Underwater-Robotic-System/Build-Instructions/images/camerastep1.jpg

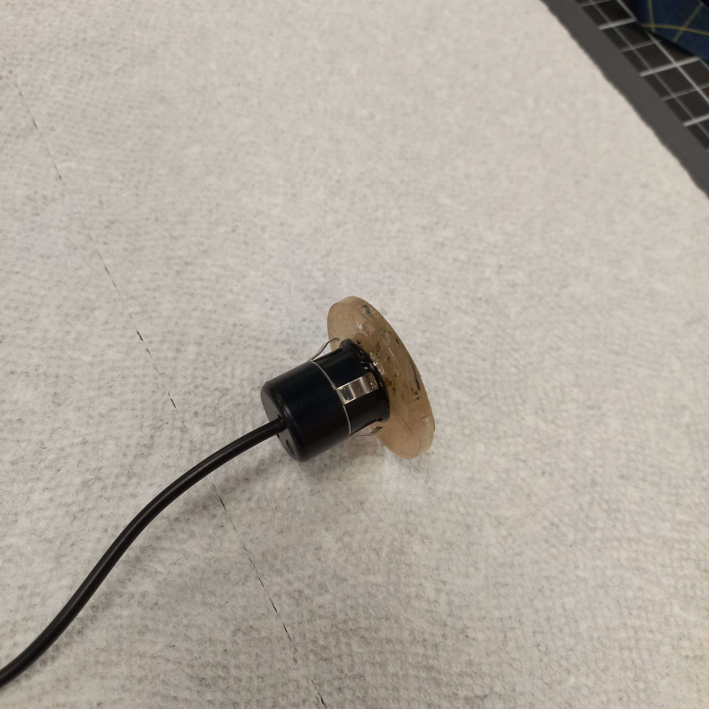
images/camerastep1.jpg
