Underwater-Robotic-System/Build-Instructions/repair_guide_code/depth_sensor_bar30_basic.ino

/* Blue Robotics MS5837 Library Example
-----------------------------------------------------

Title: Blue Robotics MS5837 Library Example

Description: This example demonstrates the MS5837 Library with a connected
sensor. The example reads the sensor and prints the resulting values
to the serial terminal.

The code is designed for the Arduino Uno board and can be compiled and
uploaded via the Arduino 1.0+ software.

-------------------------------
The MIT License (MIT)

Copyright (c) 2015 Blue Robotics Inc.

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
THE SOFTWARE IS PROVIDED "AS IS", WITHOUT WARRANTY OF ANY KIND, EXPRESS OR
IMPLIED, INCLUDING BUT NOT LIMITED TO THE WARRANTIES OF MERCHANTABILITY,
FITNESS FOR A PARTICULAR PURPOSE AND NONINFRINGEMENT. IN NO EVENT SHALL THE
AUTHORS OR COPYRIGHT HOLDERS BE LIABLE FOR ANY CLAIM, DAMAGES OR OTHER
LIABILITY, WHETHER IN AN ACTION OF CONTRACT, TORT OR OTHERWISE, ARISING FROM,
OUT OF OR IN CONNECTION WITH THE SOFTWARE OR THE USE OR OTHER DEALINGS IN
THE SOFTWARE.
-------------------------------*/

#include <Wire.h>
#include "MS5837.h"

MS5837 sensor;

void setup() {

  Serial.begin(9600);

  Serial.println("Starting");

  Wire.begin();

  // Initialize pressure sensor
  // Returns true if initialization was successful
  // We can't continue with the rest of the program unless we can initialize the sensor
  while (!sensor.init()) {
    Serial.println("Init failed!");
    Serial.println("Are SDA/SCL connected correctly?");
    Serial.println("Blue Robotics Bar30: White=SDA, Green=SCL");
    Serial.println("\n\n\n");
    delay(5000);
  }

  // .init sets the sensor model for us but we can override it if required.
  // Uncomment the next line to force the sensor model to the MS5837_30BA.
  //sensor.setModel(MS5837::MS5837_30BA);

  sensor.setFluidDensity(997); // kg/m^3 (freshwater, 1029 for seawater)
}

void loop() {
  // Update pressure and temperature readings
  sensor.read();

  Serial.print("Pressure: ");
  Serial.print(sensor.pressure());
  Serial.println(" mbar");

  Serial.print("Temperature: ");
  Serial.print(sensor.temperature());
  Serial.println(" deg C");

  Serial.print("Depth: ");
  Serial.print(sensor.depth());
  Serial.println(" m");

  Serial.print("Altitude: ");
  Serial.print(sensor.altitude());
  Serial.println(" m above mean sea level");

  delay(1000);
}
