Underwater-Robotic-System/Build-Instructions/(commit log)

2023-08-24 add data analysis
    [#1-pool-data.csv, #1_Pool_Water.csv, #2-drinkingwater.csv, #3-contaminatedwaterwithsoap.csv, final_data.csv, main-data.csv, sensor-data.csv]
2025-06-03 motor section of repair guide
