Underwater-Robotic-System/Build-Instructions/images/powercord.jpg

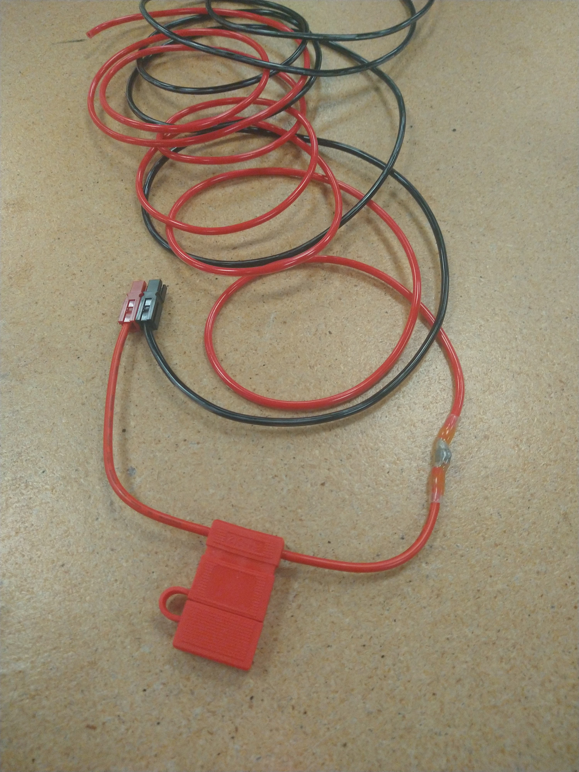
[picture p9: images/powercord.jpg]
images/powercord.jpg
