Underwater-Robotic-System/Build-Instructions/images/waterproofcam1.jpg

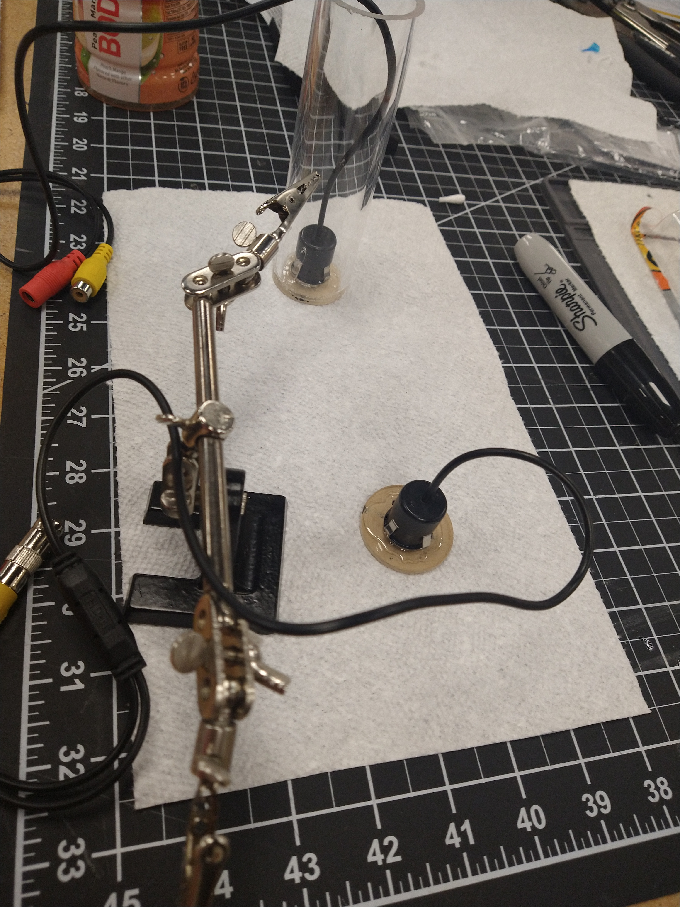
[picture p17: images/waterproofcam1.jpg]
images/waterproofcam1.jpg
