Underwater-Robotic-System/Build-Instructions/images/waterproofcam2.jpg

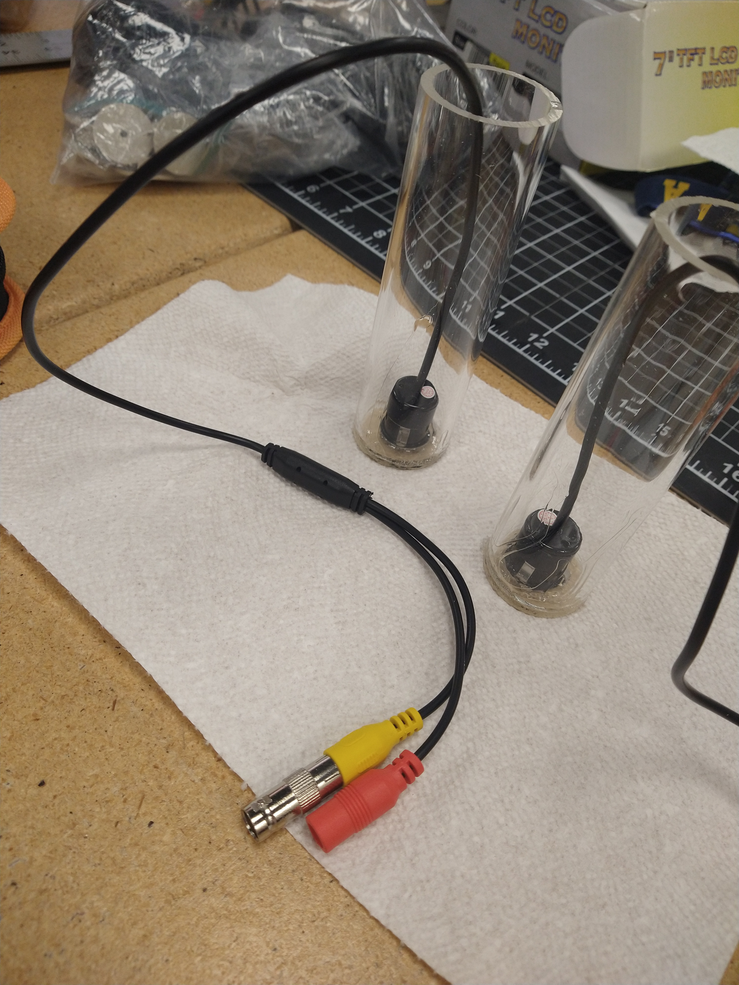
[picture p18: images/waterproofcam2.jpg]
images/waterproofcam2.jpg
