Underwater-Robotic-System/Build-Instructions/images/cableintube.jpg

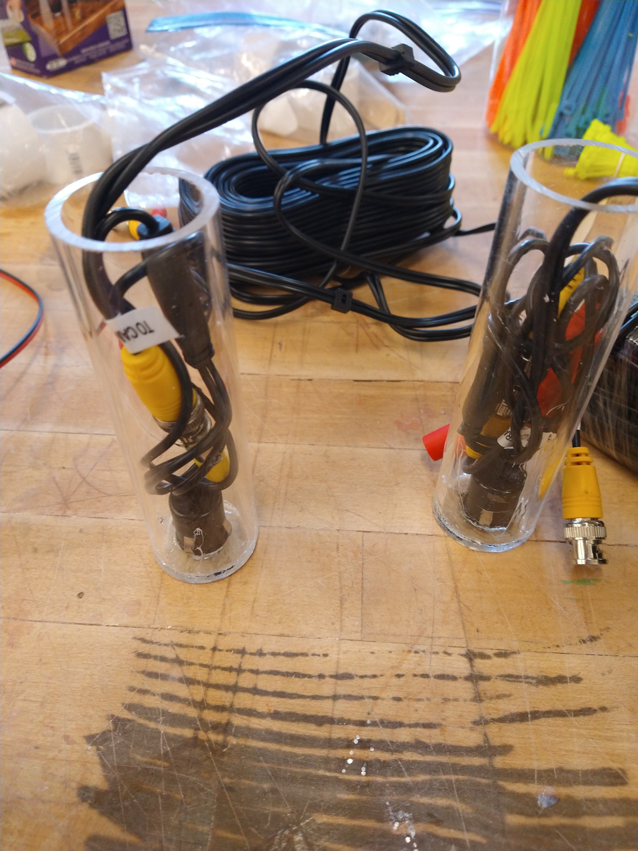
[picture p19: images/cableintube.jpg]
images/cableintube.jpg
