Underwater-Robotic-System/Build-Instructions/images/singlecamera.jpg

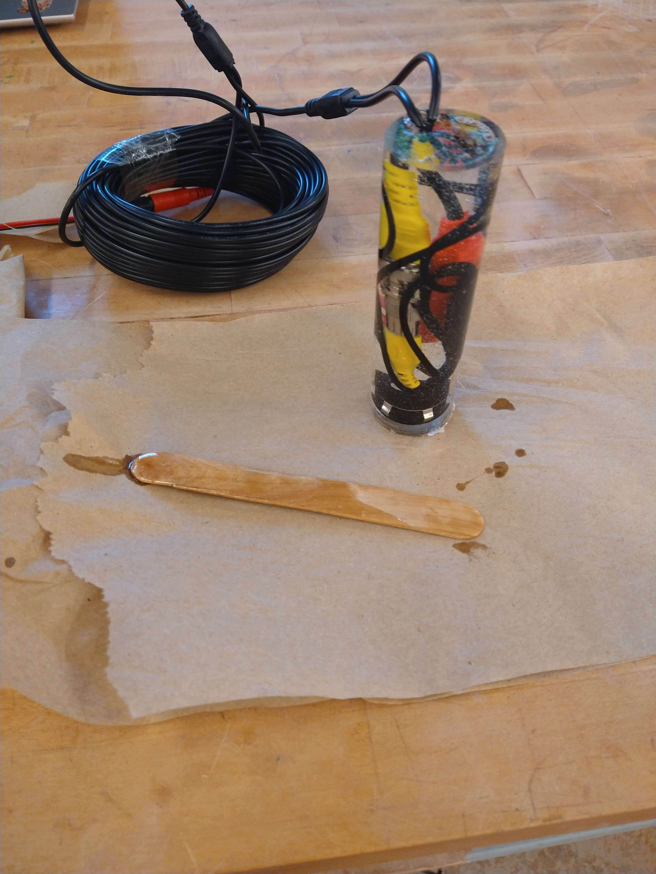
[picture p21: images/singlecamera.jpg]
images/singlecamera.jpg
