Underwater-Robotic-System/Build-Instructions/images/relaysystem.jpg

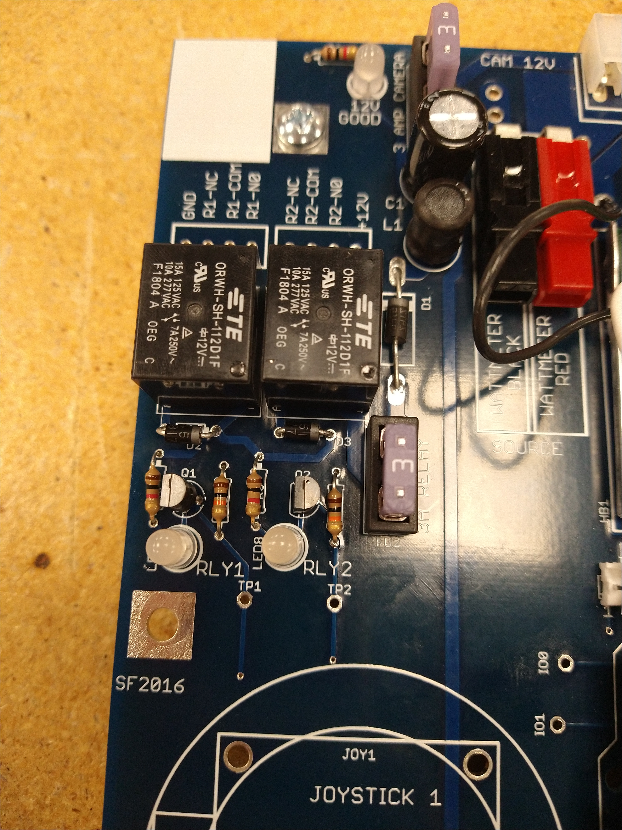
[picture p22: images/relaysystem.jpg]
images/relaysystem.jpg
